HARIKRUTHIK/Precision-Scalable-4x4-NPU/docs/PSMAC_Complete_Guide.docx

PSMAC

Precision-Scalable Multiply-Accumulate Unit

Complete Line-by-Line RTL Code Guide

8 Verilog Modules | 3 Precision Modes | 4× INT2 Throughput | 20/20 Tests Passing

What is PSMAC?

PSMAC (Precision-Scalable Multiply-Accumulate) is a hardware accelerator written in synthesisable Verilog RTL. It computes the dot product of two vectors — the core arithmetic operation of every neural network layer — while allowing the operator to switch between 8-bit, 4-bit, and 2-bit integer arithmetic at runtime with zero stall cycles and zero hardware reconfiguration.

The same silicon area that normally handles one INT8 multiplication per cycle instead handles two INT4 or four INT2 multiplications per cycle by packing multiple operands into one datapath traversal. This is the central novelty of the design.

# Section 0 — Full System Architecture

Module Hierarchy (Bottom → Top)

How modules nest inside each other

ha, fa → primitive adder cells defined inside sbb.v

sbb → 3-bit × 3-bit signed multiplier cell (uses ha + fa internally)

BBU → 4-bit × 4-bit decomposition using 4× sbb

rfu → 8-bit × 8-bit decomposition using 4× BBU; emits 80-bit packed result

weight_mem → dual 256×8 RAM (activations + weights); async read

pipe_reg → 80-bit pipeline register; isolates RFU timing

accumulator → extracts correct fields from 80-bit bus; adds to 32-bit sum

fsm → 4-state Moore controller; drives address, enables, out_valid

psmac_top → top-level integrator; wires all above + adds pipeline delay corrections

Two-Cycle Pipeline Overview

When | Stage | What Happens
Cycle N | FSM drives addr | weight_mem reads x[addr] and w[addr] combinationally → rfu computes 80-bit result immediately
Cycle N | RFU combinational | Result rfu_out_wire is ready in the same cycle — no clock edge needed
Cycle N+1 | pipe_reg latches | On the rising clock edge, pipe_reg stores rfu_out_wire → data_out is now stable
Cycle N+1 | acc_en_d1 fires | psmac_top delays acc_en by 1 cycle so it aligns with pipe_reg output
Cycle N+1 | Accumulator adds | result ← result + tree_out (the extracted partial product for this mode)
End | FSM → DONE → out_valid | ov_d1 is asserted one cycle later, confirming result is fully stable

# Section 1 — sbb.v (Sub-word Building Block)

## 1.1 Purpose

The sbb is the lowest-level compute cell in the entire design. It is a custom 3-bit × 3-bit signed multiplier built from scratch using individual gate-level adder primitives (ha, fa). It produces a 5-bit signed product.

Its unique feature is the sx and sy sign-enable flags: when sx = 0 the MSB of x is masked off, making the operand behave as unsigned. This single AND gate eliminates the need for a separate unsigned multiplier path.

## 1.2 Port List

Port | Description
x[2:0] | 3-bit input operand X (a nibble half sliced from a larger value by BBU)
y[2:0] | 3-bit input operand Y (a nibble half sliced from a larger value by BBU)
sx | Sign-enable for X: when 1, x[2] is treated as a sign bit (2's complement); when 0, x is unsigned
sy | Sign-enable for Y: same logic as sx but for Y
p[4:0] | 5-bit signed product output — the result of x × y with appropriate sign handling

## 1.3 Line-by-Line Explanation

Line | Code | Explanation
1 | module sbb ( | Declares the module named sbb. All five ports follow.
2 | input [2:0] x, | 3-bit input bus named x. Bit-0 is LSB, bit-2 is MSB.
3 | input [2:0] y, | 3-bit input bus named y.
4 | input sx, | 1-bit sign-enable for x. Passed in by BBU depending on which nibble x represents.
5 | input sy, | 1-bit sign-enable for y. Same idea for y.
6 | output signed [4:0] p | 5-bit signed output p. The 'signed' keyword tells the simulator to interpret overflow correctly.
7 | ); | Closes the port list, begins the module body.
9 | wire x2 = x[2] & sx; | KEY LINE: x2 is the effective sign bit of x. If sx=1, x2 = x[2] (normal sign). If sx=0, x2 = 0 — x is treated as unsigned automatically. One AND gate, zero extra hardware.
10 | wire y2 = y[2] & sy; | Same sign-masking for y. y2 is y's effective sign bit.
12 | wire x0y0 = x[0] & y[0]; | Partial product: bit-0 of x AND bit-0 of y. This is the AND-based multiplication of the two LSBs.
13 | wire x0y1 = x[0] & y[1]; | Partial product: x[0] × y[1]. Used to form bit-1 and bit-2 of the final product.
14 | wire x0y2 = ~(x[0] & y2); | Partial product involving the sign bit y2. The NAND (~&) is part of the Baugh-Wooley signed multiply technique — sign bits are negated in the partial product array.
15 | wire x1y0 = x[1] & y[0]; | Partial product: x[1] × y[0].
16 | wire x1y1 = x[1] & y[1]; | Partial product: x[1] × y[1]. Falls in the middle of the reduction tree.
17 | wire x1y2 = ~(x[1] & y2); | NAND partial product for the sign-bit cross term x[1]×y2.
18 | wire x2y0 = ~(x2 & y[0]); | NAND partial product for sign-bit cross term x2×y[0].
19 | wire x2y1 = ~(x2 & y[1]); | NAND partial product for sign-bit cross term x2×y[1].
20 | wire x2y2 = x2 & y2; | AND partial product of both sign bits. The only sign×sign term that remains AND (not NAND) in Baugh-Wooley.
22 | assign p[0] = x0y0; | Bit-0 of product = LSB partial product directly. No carry can affect bit-0.
25 | ha HA1 (.a(x0y1),.b(x1y0),.s(p[1]),.c(c1)); | Half Adder to sum two partial products for bit-1. The sum bit goes to p[1], carry c1 goes to the next stage.
29 | fa FA1 (.a(x1y1),.b(x2y0),.cin(c1),.s(s_fa1),.cout(c2)); | Full Adder for bit-2 level: adds x1y1 + x2y0 + carry-in c1. Produces intermediate sum s_fa1 and carry c2.
33 | ha HA2 (.a(s_fa1),.b(x0y2),.s(p[2]),.c(c3)); | Second Half Adder: combines s_fa1 and x0y2 to give p[2]. Carry c3 propagates.
37 | fa FA2 (.a(1'b1),.b(x2y1),.cin(c2),.s(s_fa2),.cout(c4)); | The constant 1'b1 here is the Baugh-Wooley correction term — needed to fix the sign-bit NAND terms. Without this '1', the signed product would be wrong.
41 | fa FA3 (.a(s_fa2),.b(x1y2),.cin(c3),.s(p[3]),.cout(c5)); | Third Full Adder: computes bit-3 of the product from the previous stage sums and carries.
44 | assign p[4] = (x2^y2)&(x[1]|x[0])&(y[1]|y[0]); | Bit-4 (the MSB / sign bit of the result). This is a compact logic expression that evaluates whether the product is negative: true only when the signs differ AND both operands are non-zero. This is a design optimisation — avoids a full carry chain up to bit-4.

## 1.4 The ha and fa Sub-modules (defined at bottom of sbb.v)

Module | Function
ha (Half Adder) | Takes two 1-bit inputs a,b. Output s = a XOR b (sum bit), c = a AND b (carry bit). Used wherever two partial products are combined.
fa (Full Adder) | Takes three 1-bit inputs a,b,cin. Internally uses two ha instances. Output s = sum, cout = carry. Used at higher bit positions where a carry-in exists.

## 1.5 Role in psmac_top

sbb is never instantiated directly by psmac_top. It is instantiated 4 times inside BBU, which is itself instantiated 4 times inside rfu. So the full design contains 16 sbb instances in total — all operating in parallel, every clock cycle, combinationally.

# Section 2 — BBU.v (Basic Building Unit)

## 2.1 Purpose

The BBU implements Karatsuba decomposition at the 4-bit level. It takes two 4-bit nibbles and splits each into a 2-bit high part and 2-bit low part, computes four 3×3 sub-products using four sbb instances, then either concatenates them (INT2 mode) or recombines them using Karatsuba's formula (INT4/INT8 modes).

The output is 20 bits wide — four 5-bit raw products packed together in INT2 mode, or one 11-bit fused product sign-extended to 20 bits in INT4/INT8 modes.

## 2.2 Port List

Port | Description
x[3:0] | 4-bit input operand X — a nibble (half of the 8-bit operand) from the rfu
y[3:0] | 4-bit input operand Y — a nibble from the rfu
sx | Sign-enable flag for x, passed through to the relevant sbb instances
sy | Sign-enable flag for y, passed through to the relevant sbb instances
mode[1:0] | Precision mode: 2'b00=INT2, 2'b01=INT4, 2'b10=INT8
out[19:0] | 20-bit output. Layout depends on mode — either four packed raw products or one fused result

## 2.3 Line-by-Line Explanation

Line | Code | Explanation
1 | module BBU( | Declares the BBU module.
2 | input [3:0] x, y, | Two 4-bit nibble inputs.
3 | input sx, sy, | Sign-enable flags, one per operand.
4 | input [1:0] mode, | 2-bit mode selector (INT2/INT4/INT8).
5 | output [19:0] out | 20-bit output — holds either packed raw sub-products or a single fused Karatsuba product.
8 | wire [2:0] xH = {x[3], x[3:2]}; | HIGH nibble of x, extended to 3 bits for sbb. {x[3],x[3:2]} sign-extends bit-3 into bit-2's position, so the sbb sees the correct 2-bit value in a 3-bit container.
9 | wire [2:0] xL = {1'b0, x[1:0]}; | LOW nibble of x, zero-extended to 3 bits. No sign in the low part — it is always treated as unsigned by the sbb (sx=0 will be passed).
10 | wire [2:0] yH = {y[3], y[3:2]}; | High nibble of y, same sign-extension treatment.
11 | wire [2:0] yL = {1'b0, y[1:0]}; | Low nibble of y, zero-extended.
13 | wire signed [4:0] p00,p01,p10,p11; | Four 5-bit signed wires to hold the four sub-products from the four sbb instances.
15 | sbb SBB00(.x(xL),.y(yL),.sx(1'b0),.sy(1'b0),.p(p00)); | SBB00 computes xL × yL. Both sign-enables are 0 — low nibbles are always unsigned in Karatsuba decomposition.
16 | sbb SBB01(.x(xL),.y(yH),.sx(1'b0),.sy(sy),.p(p01)); | SBB01 computes xL × yH. xL is unsigned (sx=0), yH may be signed (sy is passed through).
17 | sbb SBB10(.x(xH),.y(yL),.sx(sx),.sy(1'b0),.p(p10)); | SBB10 computes xH × yL. xH may be signed (sx is passed through), yL is unsigned.
18 | sbb SBB11(.x(xH),.y(yH),.sx(sx),.sy(sy),.p(p11)); | SBB11 computes xH × yH. Both may be signed — this is the most-significant sub-product.
20 | wire signed [5:0] mid = p01 + p10; | Karatsuba cross-term: sum of the two middle sub-products. This is the (xL×yH + xH×yL) term needed to reconstruct the full product. 6 bits to absorb potential carry.
21 | wire signed [10:0] p11_shifted = {{2{p11[4]}},p11,4'b0000}; | p11 (xH×yH) represents the high×high term. It must be left-shifted by 4 bits (multiplied by 2^4=16) to align with its correct bit position. Sign-extended to 11 bits.
22 | wire signed [10:0] mid_shifted = {{3{mid[5]}},mid,2'b00}; | Cross-term mid must be left-shifted by 2 bits (×4) to align with its bit position. Sign-extended.
23 | wire signed [10:0] p00_ext = {{6{p00[4]}},p00}; | p00 (xL×yL) is the low×low term. No shift needed — it already occupies bits [3:0]. Just sign-extended to 11 bits.
25 | wire signed [10:0] fused = p11_shifted + mid_shifted + p00_ext; | KARATSUBA RECONSTRUCTION: adds the three shifted partial products to get the full 4-bit × 4-bit product in 11 bits. This is the mathematical formula: result = pH×pH<<4 + (pH×pL + pL×pH)<<2 + pL×pL.
28 | wire [4:0] p00u=p00[4:0]; ... | Aliases to the four raw sub-products cast as unsigned — used in INT2 output mode where we want the raw values, not the fused sum.
31 | assign out = (mode==2'b00) ? {p11u,p10u,p01u,p00u} | INT2 MODE: output is the four 5-bit raw sub-products packed together. Each represents an independent 2-bit × 2-bit product. Total = 20 bits.
32 | : {{9{fused[10]}}, fused}; | INT4/INT8 MODE: output is the 11-bit fused Karatsuba result, sign-extended to 20 bits. The 9 extra bits are copies of the sign bit (fused[10]).

## 2.4 Role in psmac_top

BBU is instantiated 4 times inside rfu (BBU0–BBU3). It is never called directly from psmac_top. The four instances correspond to the four quadrant sub-products of the 8-bit × 8-bit Karatsuba level:

Instance | Sub-product computed
BBU0 (xL×yL) | Lower 4 bits of x × lower 4 bits of y. Both sign-enables = 0.
BBU1 (xL×yH) | Lower 4 bits of x × upper 4 bits of y. sy passed through.
BBU2 (xH×yL) | Upper 4 bits of x × lower 4 bits of y. sx passed through.
BBU3 (xH×yH) | Upper 4 bits of x × upper 4 bits of y. Both sx,sy passed through.

# Section 3 — rfu.v (Reconfigurable Functional Unit)

## 3.1 Purpose

The rfu is the full 8-bit × 8-bit computation engine. It applies Karatsuba decomposition at the 8-bit level: it splits both 8-bit operands into high and low 4-bit nibbles, instantiates four BBUs to compute all four quadrant products, then assembles a 80-bit packed output bus whose format changes based on the precision mode.

The 80-bit output is the richest data structure in the design — it simultaneously contains all the information needed for INT2, INT4, and INT8 results, packed into specific bit fields that the accumulator later extracts.

## 3.2 Port List

Port | Description
x[7:0] | Full 8-bit activation operand
y[7:0] | Full 8-bit weight operand
sx | Sign-enable for x — whether the MSB of x should be treated as sign
sy | Sign-enable for y — whether the MSB of y should be treated as sign
mode[1:0] | Precision selector: 2'b10=INT8, 2'b01=INT4, 2'b00=INT2
out[79:0] | 80-bit packed result. Bit-field layout depends on mode

## 3.3 Line-by-Line Explanation

Line | Code | Explanation
1 | module rfu( | Declares the rfu module.
7 | wire [3:0] xH = x[7:4]; | High nibble of x: bits 7 down to 4. These are the most significant 4 bits.
8 | wire [3:0] xL = x[3:0]; | Low nibble of x: bits 3 down to 0. These are the least significant 4 bits.
9 | wire [3:0] yH = y[7:4]; | High nibble of y.
10 | wire [3:0] yL = y[3:0]; | Low nibble of y.
12 | wire [19:0] p0,p1,p2,p3; | Four 20-bit wires for the four BBU outputs. Each BBU produces 20 bits (either 4×5-bit raw or 1×11-bit fused sign-extended).
14 | BBU BBU0(.x(xL),.y(yL),.sx(1'b0),.sy(1'b0),.mode(mode),.out(p0)); | BBU0 computes the xL×yL quadrant. Low×low is always unsigned — both sign flags hardwired to 0.
15 | BBU BBU1(.x(xL),.y(yH),.sx(1'b0),.sy(sy),.mode(mode),.out(p1)); | BBU1 computes xL×yH. xL unsigned, yH sign depends on sy.
16 | BBU BBU2(.x(xH),.y(yL),.sx(sx),.sy(1'b0),.mode(mode),.out(p2)); | BBU2 computes xH×yL. xH sign depends on sx, yL unsigned.
17 | BBU BBU3(.x(xH),.y(yH),.sx(sx),.sy(sy),.mode(mode),.out(p3)); | BBU3 computes xH×yH. Both signs passed through — this is the highest-significance quadrant.
19 | wire signed [10:0] p0_11 = $signed(p0[10:0]); | Extract the lower 11 bits of BBU0's output and interpret as signed. In INT4/INT8 mode, bits[10:0] of each BBU hold the fused 11-bit Karatsuba product.
20 | wire signed [10:0] p1_11 = $signed(p1[10:0]); | Same for BBU1's fused product.
21 | wire signed [10:0] p2_11 = $signed(p2[10:0]); | Same for BBU2's fused product.
22 | wire signed [10:0] p3_11 = $signed(p3[10:0]); | Same for BBU3's fused product.
24 | wire signed [11:0] mid = p1_11 + p2_11; | Karatsuba cross-term at the 8-bit level: sum of the two middle BBU outputs (xL×yH + xH×yL). 12 bits to hold the sum without overflow.
25 | wire signed [18:0] p3_shifted = {p3_11,8'b0}; | BBU3 (xH×yH) result shifted left 8 bits — equivalent to multiplying by 2^8=256. Aligns the high×high quadrant to its correct position in the 16-bit product.
26 | wire signed [18:0] mid_shifted = {{3{mid[11]}},mid,4'b0}; | Cross-term shifted left 4 bits (×16). Sign-extended to 19 bits.
27 | wire signed [18:0] p0_ext = {{8{p0_11[10]}},p0_11}; | BBU0 (xL×yL) result, no shift needed — already at bit position 0. Sign-extended to 19 bits.
28 | wire signed [18:0] fused_ext = p3_shifted+mid_shifted+p0_ext; | INT8 KARATSUBA RECONSTRUCTION: adds the three shifted partial products to get the complete 8-bit × 8-bit product.
29 | wire signed [15:0] fused = fused_ext[15:0]; | Truncate to 16 bits — the maximum result width for 8-bit × 8-bit signed multiplication (range: −32768 to +32767).
31 | assign out = (mode==2'b00) | Begin the 3-way output MUX — the key mode-switching logic.
32 | ? {p3[19:0],p2[19:0],p1[19:0],p0[19:0]} | INT2 MODE: concatenate all four full 20-bit BBU outputs into 80 bits. Each BBU holds four 5-bit raw 2×2 products packed together, giving 16 independent 2-bit products per rfu call.
33 | : (mode==2'b01) | Check for INT4 mode.
34 | ? {36'b0,p3[10:0],p2[10:0],p1[10:0],p0[10:0]} | INT4 MODE: take only the lower 11 bits (fused product) from each BBU and pack them into 44 bits, padded with 36 zeros to fill the 80-bit bus.
35 | : {64'b0, fused}; | INT8 MODE: only the 16-bit fused result matters. Placed in bits[15:0], upper 64 bits are zero.

## 3.4 The 80-bit Output Bus — Bit Field Map

How the 80-bit bus is populated in each mode

INT8 (mode=2'b10): bits[79:16] = 0 | bits[15:0] = 16-bit fused INT8 product

INT4 (mode=2'b01): bits[79:44]=0 | [43:33]=BBU3.fused | [32:22]=BBU2.fused | [21:11]=BBU1.fused | [10:0]=BBU0.fused

INT2 (mode=2'b00): bits[79:60]=BBU3 raw 20b | [59:40]=BBU2 raw 20b | [39:20]=BBU1 raw 20b | [19:0]=BBU0 raw 20b

The accumulator uses this map to know exactly which bits to sign-extend and sum, depending on mode_out.

# Section 4 — weight_mem.v (Dual Memory Bank)

## 4.1 Purpose

The weight_mem stores both the activation vector (x_mem) and the weight vector (w_mem) in two independent 256-entry × 8-bit RAM banks. Writes are synchronous (one byte per clock edge). Reads are fully asynchronous (combinational) — the output x_out and w_out appear in the same cycle that addr is driven, with no clock delay.

This asynchronous read is a deliberate design choice: it allows the RFU to start computing in Cycle N (the same cycle the FSM drives the address), which is what makes the 2-cycle pipeline tight.

## 4.2 Port List

Port | Description
clk | Clock input — used only for synchronous writes
addr[7:0] | Read address driven by FSM. Same address used for both banks simultaneously
we_w | Write enable for weight bank — when high, w_mem[w_addr] ← w_data on clock edge
w_addr[7:0] | Write address for weight bank
w_data[7:0] | 8-bit data to write into weight bank
we_x | Write enable for activation bank
x_addr[7:0] | Write address for activation bank
x_data[7:0] | 8-bit data to write into activation bank
x_out[7:0] | Async read output: current activation byte at addr
w_out[7:0] | Async read output: current weight byte at addr

## 4.3 Line-by-Line Explanation

Line | Code | Explanation
1 | module weight_mem #(parameter DEPTH=256)( | Parameterized module — DEPTH can be overridden at instantiation. Default is 256 entries.
8 | reg [7:0] x_mem [0:DEPTH-1]; | Declares the activation RAM: an array of DEPTH (256) registers, each 8 bits wide.
9 | reg [7:0] w_mem [0:DEPTH-1]; | Declares the weight RAM: same structure. Two independent banks.
11 | assign x_out = x_mem[addr]; | ASYNCHRONOUS READ for activations: x_out is a continuous assignment — it updates immediately whenever addr changes, with no clock edge required. This is what makes Cycle N computation possible.
12 | assign w_out = w_mem[addr]; | ASYNCHRONOUS READ for weights: same — w_out updates immediately with addr.
14 | always @(posedge clk) begin | Synchronous write block — only triggers on the rising clock edge.
15 | if (we_w) w_mem[w_addr] <= w_data; | If write-enable for weights is high, write w_data into w_mem at address w_addr. Non-blocking assignment (<=) ensures correct sequential behaviour.
18 | always @(posedge clk) begin | Second synchronous write block — for the activation bank.
19 | if (we_x) x_mem[x_addr] <= x_data; | If write-enable for activations is high, write x_data into x_mem at x_addr.

## 4.4 Role in psmac_top

weight_mem is instantiated once as WEIGHT_MEM in psmac_top. The addr input comes from the FSM's addr counter. The we_w/we_x write ports are connected directly to the top-level input pins, so the user can preload both memories before asserting psmac_en. The x_out and w_out outputs feed directly into the rfu instance.

# Section 5 — pipe_reg.v (Pipeline Register)

## 5.1 Purpose

The pipe_reg is a clocked 80-bit D-flip-flop bank. Its only job is to hold the RFU's combinational output stable for one clock cycle before the accumulator reads it. This stage-break is what converts the design from a pure combinational path (which would have a very long critical path) into a 2-stage pipeline with manageable timing.

It also latches mode, sx, and sy alongside the data, so the accumulator always knows what mode was in effect when this particular result was computed — even if the user changes mode between cycles.

## 5.2 Port List

Port | Description
clk | Clock — all latching happens on the rising edge
rst | Synchronous reset — all outputs go to zero
en | Enable signal — output only updates when en=1 (connected to pipe_en from FSM)
sx, sy | Sign-enable flags — latched alongside the data
mode_in[1:0] | Precision mode — latched alongside the data
rfu_out[79:0] | 80-bit combinational result from the rfu — this is what gets latched
data_out[79:0] | Registered output — stable 80-bit value for the accumulator
mode_out[1:0] | Registered mode — tells accumulator how to interpret data_out
sx_out,sy_out | Registered sign flags — forwarded to accumulator

## 5.3 Line-by-Line Explanation

Line | Code | Explanation
1 | module pipe_reg( | Declares the pipeline register module.
2 | input clk,rst,en,sx,sy, | All control signals declared in one line. en controls whether the register captures a new value this cycle.
3 | input [1:0]mode_in, | The current precision mode — must be stored alongside data so accumulator knows how to interpret it.
4 | input [79:0]rfu_out, | The 80-bit combinational output of the RFU — this is the new data to potentially latch.
5 | output reg [79:0] data_out, | Registered (clocked) 80-bit output. 'reg' means it holds its value between clock edges.
6 | output reg [1:0]mode_out, | Registered mode output.
7 | output reg sx_out, sy_out | Registered sign flag outputs.
10 | always @(posedge clk) begin | All logic triggers on the rising clock edge only.
11 | if (rst) begin | Synchronous reset: if rst is high at the clock edge, clear all outputs.
12 | data_out<=0; | Reset data to zero. Non-blocking — all resets happen simultaneously.
13 | mode_out<=0; sx_out<=0; sy_out<=0; | Reset metadata signals to zero.
16 | else if (en) begin | Only update if en=1 (pipe_en from FSM). This prevents the register from capturing garbage during IDLE/CLEAR states.
17 | data_out<=rfu_out; | Latch the RFU's current 80-bit output. On the next cycle, data_out is stable.
18 | mode_out<=mode_in; | Latch the current mode — ensures the accumulator uses the mode that was active during this computation.
19 | sx_out<=sx; sy_out<=sy; | Latch sign flags for the same reason.

## 5.4 Role in psmac_top

pipe_reg is instantiated as PIPELINE in psmac_top. Its en input is pipe_en from the FSM (active during RUN and DONE states). Its data_out feeds the accumulator. Its mode_out tells the accumulator which bit fields to extract. The key insight: pipe_reg output is always one cycle behind the rfu output, which is why acc_en must also be delayed by one cycle (acc_en_d1 in psmac_top).

# Section 6 — accumulator.v (Precision-Aware Accumulator)

## 6.1 Purpose

The accumulator is where the final dot-product sum is built up. It receives the 80-bit packed bus from pipe_reg and uses mode_out to determine which bit fields hold valid numerical results. It sign-extends those fields to 32 bits and adds them to a running result register.

This is the module that makes the throughput multiplier real: in INT4 mode, it adds two products per cycle; in INT2 mode, it adds four products per cycle — all from a single 80-bit bus read.

## 6.2 Port List

Port | Description
clk | Clock input
rst | Synchronous reset — clears result to zero
data_out[79:0] | 80-bit packed input from pipe_reg
mode_out[1:0] | Precision mode from pipe_reg — controls which bit fields to extract
acc_en | Accumulate enable — when high, result ← result + tree_out (this is acc_en_d1 from psmac_top, not the raw FSM signal)
clear | Clear enable — resets result to zero (used at start of each computation)
result[31:0] | 32-bit signed accumulated output — the final dot-product answer

## 6.3 Line-by-Line Explanation

Line | Code | Explanation
1 | module accumulator( | Declares the accumulator module.
7 | wire signed [31:0] int8_sum = {{16{data_out[15]}},data_out[15:0]}; | INT8 extraction: take bits[15:0] (the 16-bit fused Karatsuba result from rfu) and sign-extend it to 32 bits by replicating bit-15 sixteen times. {{16{data_out[15]}}} is Verilog sign-extension syntax.
10 | wire signed [31:0] int4_p0 = {{21{data_out[10]}},data_out[10:0]}; | INT4 first product: extract bits[10:0] — the BBU0 fused result (xL×yL quadrant). Sign-extended to 32 bits. This represents the dot product of the lower nibbles.
11 | wire signed [31:0] int4_p3 = {{21{data_out[43]}},data_out[43:33]}; | INT4 second product: extract bits[43:33] — the BBU3 fused result (xH×yH quadrant). Sign-extended. This represents the dot product of the upper nibbles. Two independent 4-bit products in one cycle.
12 | wire signed [31:0] int4_sum = int4_p0 + int4_p3; | Add the two INT4 products together. This gives the total contribution of both 4-bit pairs for this cycle to the running dot product.
15 | wire signed [31:0] int2_p0 = {{27{data_out[4]}},data_out[4:0]}; | INT2 product 0: bits[4:0] = SBB00 inside BBU0 = x[1:0]×y[1:0] (the very lowest 2-bit pair). Sign-extended to 32 bits.
16 | wire signed [31:0] int2_p1 = {{27{data_out[19]}},data_out[19:15]}; | INT2 product 1: bits[19:15] = SBB11 inside BBU0 = x[3:2]×y[3:2] (second 2-bit pair). These are the high sub-products of BBU0.
17 | wire signed [31:0] int2_p2 = {{27{data_out[64]}},data_out[64:60]}; | INT2 product 2: bits[64:60] = SBB00 inside BBU3 = x[5:4]×y[5:4] (third 2-bit pair). From BBU3's raw output region.
18 | wire signed [31:0] int2_p3 = {{27{data_out[79]}},data_out[79:75]}; | INT2 product 3: bits[79:75] = SBB11 inside BBU3 = x[7:6]×y[7:6] (the highest 2-bit pair).
19 | wire signed [31:0] int2_sum = int2_p0+int2_p1+int2_p2+int2_p3; | Add all four INT2 products: four independent 2-bit × 2-bit results accumulated in a single cycle. This is 4× the throughput of INT8.
21 | wire signed [31:0] tree_out = (mode_out==2'b10) ? int8_sum : | Mode-select MUX: if INT8, the single 16-bit product is used.
22 | (mode_out==2'b01) ? int4_sum : int2_sum; | If INT4, the sum of two 4-bit products. Otherwise INT2, sum of four 2-bit products. tree_out is the contribution of this one pipeline stage to the final dot product.
24 | always @(posedge clk) begin | Clocked accumulation logic.
25 | if (rst) result <= 32'b0; | Synchronous reset: result goes to zero immediately on rst.
26 | else if (clear) result <= 32'b0; | Clear command from FSM (CLEAR state): reset before a new computation starts.
27 | else if (acc_en) result <= result + tree_out; | ACCUMULATION: on each clock where acc_en=1, add tree_out to the running sum. This builds up the dot product over vec_len/run_target cycles.

## 6.4 Role in psmac_top

Instantiated as ACCUMULATOR. Receives data_out and mode_out from pipe_reg. The critical point: its acc_en input is connected to acc_en_d1 (not the raw FSM acc_en) — this 1-cycle delay is what synchronises it with the pipe_reg latency. Without this delay, the accumulator would read the previous cycle's pipe_reg output instead of the current one.

# Section 7 — fsm.v (Finite State Machine Controller)

## 7.1 Purpose

The fsm is the 4-state Moore FSM that orchestrates the entire dot-product computation. It controls the memory address counter, the pipeline and accumulator enables, and the output-valid signal. It also implements the throughput-scaling logic: by computing run_target as a right-shifted version of vec_len, it automatically runs fewer cycles in lower-precision modes — because each RFU cycle packs more work.

## 7.2 States

State | Behaviour
IDLE (2'b00) | Waits for psmac_en=1. No outputs are asserted. The FSM sits here between computations.
CLEAR (2'b01) | Asserts clear=1 for one cycle to zero the accumulator. Resets the address counter. Immediately transitions to RUN.
RUN (2'b10) | The main compute state. Each cycle: increments addr counter, asserts acc_en and pipe_en. Runs for run_target cycles.
DONE (2'b11) | Computation complete. Asserts out_valid (registered). Holds pipe_en high for one extra cycle to drain the pipeline. Returns to IDLE.

## 7.3 Line-by-Line Explanation

Line | Code | Explanation
1 | module fsm( | Declares the FSM module.
9 | parameter IDLE=2'b00; CLEAR=2'b01; | State encoding constants. 2-bit binary encoding for 4 states.
10 | parameter RUN=2'b10; DONE=2'b11; | RUN and DONE state encodings.
13 | reg [1:0] state, next_state; | Current state register and next-state combinational wire (declared as reg for always block use).
14 | reg [7:0] counter; | 8-bit address counter — incremented every cycle in RUN state, drives the memory address.
15 | reg [7:0] run_target; | Computed number of cycles needed for this precision mode and vector length.
17 | always @(*) begin | Combinational block — run_target is computed continuously based on mode.
18 | case(mode) | Switch on current mode.
19 | 2'b10: run_target = vec_len; | INT8 mode: one product per cycle, so run exactly vec_len cycles.
20 | 2'b01: run_target = vec_len >> 1; | INT4 mode: two products per cycle (one rfu call handles 2 pairs), so need only vec_len/2 cycles.
21 | 2'b00: run_target = vec_len >> 2; | INT2 mode: four products per cycle, so need only vec_len/4 cycles. This is where 4× throughput comes from.
26 | always @(posedge clk) begin | Sequential block: state register and counter update on clock edge.
27 | if (rst) begin state<=IDLE; counter<=0; | On reset: go to IDLE, clear counter.
31 | state <= next_state; | Update current state to whatever the combinational next-state logic computed.
32 | case(state) | Counter update logic: counter only increments in RUN state.
33 | IDLE: counter <= 8'b0; | Reset counter to 0 in IDLE.
34 | CLEAR: counter <= 8'b0; | Keep counter at 0 in CLEAR (about to start RUN).
35 | RUN: counter <= counter + 1; | Increment counter every cycle in RUN. This counter drives addr, so memory steps through entries 0,1,2,...
40 | always @(*) begin | Combinational next-state logic.
42 | IDLE: next_state = psmac_en?CLEAR:IDLE; | If psmac_en asserts, go to CLEAR; otherwise stay in IDLE.
43 | CLEAR: next_state = RUN; | Always go directly to RUN after CLEAR — clearing takes exactly 1 cycle.
44 | RUN: next_state = (counter==run_target-1)?DONE:RUN; | Stay in RUN until counter reaches run_target-1, then go to DONE. The -1 accounts for the counter updating on the same edge as the state transition.
45 | DONE: next_state = IDLE; | Always return to IDLE after DONE. One-cycle DONE state.
49 | always @(*) begin | Combinational output logic (Moore: outputs depend only on current state, not inputs).
50 | clear=0; acc_en=0; pipe_en=0; addr=0; | Default: all outputs deasserted. Safe default prevents latches.
53 | CLEAR: begin clear=1'b1; end | In CLEAR state: assert clear to zero the accumulator.
54 | RUN: begin acc_en=1; pipe_en=1; addr=counter; end | In RUN state: assert acc_en (will become acc_en_d1 after delay in psmac_top), pipe_en (allows pipe_reg to latch), and drive addr from counter.
55 | DONE: begin pipe_en=1; end | In DONE state: keep pipe_en high for one extra cycle to flush the final value through pipe_reg into the accumulator.
58 | always @(posedge clk) begin | Registered out_valid — must be a flip-flop to avoid glitches.
60 | else if (state==DONE) out_valid<=1'b1; | Assert out_valid when DONE state is reached.
61 | else if (state==IDLE && psmac_en) out_valid<=1'b0; | De-assert out_valid at the start of a new computation so it doesn't stay high from the previous run.

# Section 8 — psmac_top.v (Top-Level Integration)

## 8.1 Purpose

The psmac_top is the top-level system integrator. It does not perform any arithmetic itself. Its job is to:

- Instantiate all six sub-modules (fsm, weight_mem, rfu, pipe_reg, accumulator)
- Wire all their ports together in the correct order
- Apply two timing corrections that are the top module's responsibility: acc_en_d1 and ov_d1
- Expose debug probes so internal signals can be monitored during simulation

## 8.2 Complete Port List

Port | Description
clk | System clock — shared by all sub-modules
rst | Synchronous active-high reset — propagated to all sub-modules
psmac_en | Start trigger: rising edge (while in IDLE) begins a new dot-product computation
mode[1:0] | Precision mode: 2'b10=INT8, 2'b01=INT4, 2'b00=INT2. Can change between computations.
sx | Sign-enable for activation vector x: 1=signed, 0=unsigned
sy | Sign-enable for weight vector y: 1=signed, 0=unsigned
vec_len[7:0] | Number of elements in the vectors to dot-product. FSM computes run_target from this.
we_w | Write-enable for weight memory — load weights before asserting psmac_en
w_addr[7:0] | Address to write a weight byte into
w_data[7:0] | Weight byte value to write
we_x | Write-enable for activation memory
x_addr[7:0] | Address to write an activation byte into
x_data[7:0] | Activation byte value to write
result[31:0] | Final 32-bit signed dot-product result — valid when out_valid=1
out_valid | Pulses high for 1 cycle when result is ready (ov_d1 delayed version)
dbg_x_out | Debug probe: current activation byte being read from memory
dbg_w_out | Debug probe: current weight byte being read from memory
dbg_rfu_out | Debug probe: raw 80-bit rfu combinational output
dbg_pipe_out | Debug probe: 80-bit registered pipe_reg output
dbg_acc_en_d2 | Debug probe: the delayed acc_en_d1 signal going to accumulator
dbg_pipe_en | Debug probe: pipe_en from FSM
dbg_acc_en_fsm | Debug probe: raw acc_en from FSM (before delay)

## 8.3 The Two Critical Timing Corrections

Why these corrections are needed and exactly what they do

Correction 1: acc_en_d1

The FSM asserts acc_en in the RUN state. At that moment, the rfu has just computed a result — but the accumulator must read from pipe_reg, which is one cycle behind. If we gave acc_en directly to the accumulator, it would add the previous cycle's pipe_reg value (wrong). By delaying acc_en by one flip-flop (acc_en_d1), the enable arrives exactly when pipe_reg holds the correct latched value.

Correction 2: ov_d1 (out_valid delay)

The FSM asserts out_valid_fsm in the DONE state. But the last accumulation (acc_en_d1 firing) happens in the cycle after DONE. So out_valid needs one more cycle of delay to assert only after result is truly stable. ov_d1 provides this.

## 8.4 Line-by-Line Explanation

Line | Code | Explanation
1 | module psmac_top( | Declares the top-level module.
28 | wire clear,acc_en,pipe_en,out_valid_fsm; | Internal wires for FSM outputs. These carry signals between the FSM instance and the sub-module instances.
29 | wire [7:0] addr; | 8-bit address wire from FSM to weight_mem.
30 | wire [7:0] x_out,w_out; | 8-bit data wires from weight_mem to rfu.
31 | wire [79:0] rfu_out_wire; | 80-bit wire from rfu output to pipe_reg input.
32 | wire [79:0] data_out; | 80-bit wire from pipe_reg output to accumulator input.
33 | wire [1:0] mode_out; | 2-bit wire carrying latched mode from pipe_reg to accumulator.
34 | wire sx_out,sy_out; | 1-bit wires carrying latched sign flags from pipe_reg (not used by accumulator in current version, but available).
40 | reg acc_en_d1; | The 1-cycle-delayed version of acc_en. This is the signal actually passed to the accumulator.
41 | always @(posedge clk) begin | Sequential logic for acc_en_d1.
42 | if (rst) acc_en_d1<=1'b0; | On reset, clear the delayed enable.
43 | else acc_en_d1<=acc_en; | On every clock edge, capture the current acc_en. Output is therefore always exactly 1 cycle behind acc_en.
46 | reg ov_d1; | The 1-cycle-delayed out_valid. This is the signal exposed at the top-level out_valid port.
47 | always @(posedge clk) begin | Sequential logic for ov_d1.
49 | ov_d1<=out_valid_fsm; | Capture the FSM's raw out_valid. One cycle later, ov_d1 = 1 when result is stable.
51 | assign out_valid=ov_d1; | The top-level out_valid output is the delayed version.
53 | fsm FSM(...); | Instantiate the FSM. Connects: psmac_en, mode, vec_len → inputs; clear, acc_en, pipe_en, out_valid_fsm, addr → outputs.
63 | weight_mem #(.DEPTH(256)) WEIGHT_MEM(...); | Instantiate weight_mem with DEPTH=256. Connects: addr from FSM; we_w/w_addr/w_data and we_x/x_addr/x_data from top ports; x_out/w_out → rfu.
71 | rfu RFU(...); | Instantiate rfu. x=x_out, y=w_out, sx/sy/mode from top ports → out goes to rfu_out_wire.
78 | pipe_reg PIPELINE(...); | Instantiate pipe_reg. en=pipe_en from FSM, rfu_out=rfu_out_wire → data_out/mode_out for accumulator.
87 | accumulator ACCUMULATOR(...); | Instantiate accumulator. data_out and mode_out from pipe_reg, acc_en=acc_en_d1 (delayed), clear from FSM → result output.
95 | assign dbg_x_out = x_out; | Debug wires: expose internal signals to top-level ports for simulation testbench inspection.
96 | assign dbg_rfu_out = rfu_out_wire; | Exposes the raw 80-bit rfu output before the pipeline register — useful to compare against dbg_pipe_out.
97 | assign dbg_acc_en_d2 = acc_en_d1; | Exposes the delayed enable — so the testbench can verify the timing correction is working.

# Section 9 — Novelty of PSMAC

PSMAC's novelty consists of four interlocking contributions. Each is described below, with the specific line of code that implements it.

## Novelty 1 — Two-Level Karatsuba Hierarchy as a Precision Dial

What it is

Standard hardware multipliers are built for a single fixed width (e.g., a dedicated 8-bit multiplier). PSMAC instead implements a two-level Karatsuba decomposition: level 1 inside rfu splits 8-bit operands into 4-bit nibbles; level 2 inside BBU splits 4-bit nibbles into 2-bit sub-words. This means the hardware naturally generates products at three granularities simultaneously — 2-bit×2-bit, 4-bit×4-bit, and 8-bit×8-bit — from the same gate-level adder tree.

The mode selector is a zero-cost output MUX: it simply chooses which fields of the 80-bit bus to send to the accumulator. No extra computation is added or removed. The hardware always does the same work; the mode only changes how the results are interpreted.

Where in the code:

Location | What it does
BBU.v line 31-32 | OUT MUX: mode==2'b00 → raw sub-products (INT2), else → fused Karatsuba result (INT4/INT8)
rfu.v line 31-35 | 3-way output MUX: INT8 → 16-bit fused, INT4 → four 11-bit fused, INT2 → four 20-bit raw
accumulator.v 21-22 | tree_out MUX: extracts correct fields from 80-bit bus based on mode_out

## Novelty 2 — Sign Reconfigurability via sx/sy Flags with Zero Gate Overhead

What it is

Conventional precision-scalable designs handle signed vs unsigned modes either by duplicating hardware (one signed path + one unsigned path, then mux the output) or by pre-processing operands in software. Both approaches add area or latency.

PSMAC introduces a bit-level sign masking technique: inside sbb, the line wire x2 = x[2] & sx; implements the complete signed/unsigned switch with a single AND gate. When sx=0, x2 is always 0 — the MSB is masked off and the operand behaves as unsigned. When sx=1, x2=x[2] — normal signed 2's complement multiplication. This principle propagates naturally through BBU and rfu via selective pass-through of the sx/sy signals to only the appropriate sbb instances.

Where in the code:

Location | What it does
sbb.v line 9 | wire x2 = x[2] & sx; — the single AND gate that implements the entire signed/unsigned decision
BBU.v line 15-18 | sx/sy propagation: SBB00 gets (0,0), SBB01 gets (0,sy), SBB10 gets (sx,0), SBB11 gets (sx,sy) — matches mathematical sign rules
rfu.v line 14-17 | sx/sy propagation continues at 8-bit level with same quadrant-aware rules
pipe_reg.v | sx,sy latched alongside data — mode metadata preserved across pipeline stage

## Novelty 3 — Runtime Mode Switching with Zero Stall Cycles

What it is

Most flexible-precision accelerators require a pipeline flush, a mode register write, or a clock-gating reconfiguration before the precision can change. All of these cost cycles. PSMAC requires none of them.

The mode[1:0] wire feeds directly into: (a) the BBU output MUX, (b) the rfu output MUX, (c) the accumulator field-extraction logic, and (d) the FSM run_target computation. All of these are purely combinational. A new psmac_en pulse with a different mode simply starts a new computation at the new precision — effective on the very next CLEAR→RUN transition, with no overhead.

Where in the code:

Location | What it does
fsm.v line 17-22 | run_target recalculated every cycle combinationally from mode — immediate response to mode change
rfu.v line 31-35 | Output MUX is a combinational assign — no register holds old mode state
psmac_top.v | mode is passed directly (not registered) to rfu and through pipe_reg to accumulator

## Novelty 4 — FSM-Driven Throughput Scaling via run_target

What it is

Simply packing multiple operands into one datapath traversal is not enough — the control logic must also know how many cycles to run. The FSM's run_target variable is computed as vec_len >> {0,1,2} depending on mode. This means the hardware literally runs fewer clock cycles in lower-precision modes because each cycle contributes proportionally more to the dot product.

A 32-element vector dot product: INT8 requires 32 cycles, INT4 requires 16 cycles, INT2 requires just 8 cycles — using identical hardware. This is genuine throughput improvement, not just a relabelling of results.

Throughput table:

Mode | FSM run_target formula | Effective throughput
INT8 (2'b10) | run_target = vec_len | 1 product per cycle — baseline
INT4 (2'b01) | run_target = vec_len >> 1 | 2 products per cycle — 2× faster
INT2 (2'b00) | run_target = vec_len >> 2 | 4 products per cycle — 4× faster

Where in the code:

Location | What it does
fsm.v line 17-22 | run_target case statement — the 3-line implementation of the entire throughput scaling mechanism
fsm.v line 44 | (counter==run_target-1)?DONE:RUN — loop termination condition uses run_target
accumulator.v 19 | int2_sum = int2_p0+int2_p1+int2_p2+int2_p3 — 4 products added in one cycle

# Section 10 — PSMAC vs Alternative Designs

Feature | Fixed MAC | Clock-gated Flex | Systolic Array | PSMAC (This Work)
Supported precisions | 1 (fixed) | 2–3 | 1–2 | 3 (INT2/4/8)
Throughput gain at INT2 | None | None | Limited | 4× per cycle
Mode switch cost | N/A | Flush + config | Context switch | 0 cycles
Sign config method | Fixed | Separate path | Fixed | sx/sy flags (1 gate)
Sub-word packing | No | No | Partial | Yes, full 3-level
Karatsuba decomposition | No | No | No | Yes, 2-level
Extra area per mode | Full new die | Moderate | Large | Zero
Control complexity | Minimal | Moderate | High | 4-state FSM

# Section 11 — Complete Signal Flow: One Dot-Product Computation

## Step 1: Load Data (before psmac_en)

User drives we_x=1, x_addr=0..N-1, x_data=activation_bytes — fills x_mem. Then drives we_w=1, w_addr=0..N-1, w_data=weight_bytes — fills w_mem. Sets mode, sx, sy, vec_len.

## Step 2: Start (psmac_en = 1)

FSM: IDLE → CLEAR. One cycle: clear=1 zeroes the accumulator. FSM: CLEAR → RUN.

## Step 3: RUN state (run_target cycles)

Each cycle in RUN: FSM drives addr=counter → weight_mem outputs x_out, w_out combinationally → RFU computes 80-bit result → pipe_reg latches on clock edge (en=pipe_en) → one cycle later, acc_en_d1 fires → accumulator adds extracted partial products to result.

## Step 4: DONE state

FSM: RUN → DONE. pipe_en stays high for one drain cycle. out_valid_fsm=1. After ov_d1 delay, out_valid=1 at the top-level port. result holds the final 32-bit dot product.

## Step 5: Return to IDLE

FSM: DONE → IDLE. Ready for next computation. mode can be changed freely.

# Summary

2-Level Karatsuba Hierarchy | 1 Gate Sign Reconfiguration | 0 Stalls Mode Switch Cost | 4× INT2 Throughput Gain

Key Takeaway

Every module in PSMAC exists to serve one idea: the same adder tree that does one 8-bit multiply can simultaneously do four 2-bit multiplies — but only if the decomposition, sign-masking, output packing, accumulation, and control are all designed together as a unified system. That unified co-design is the essence of what makes PSMAC novel.

PSMAC · Precision-Scalable MAC · Verilog IEEE 1364-2001 · 8 Modules · 20/20 Tests Passing
