HARIKRUTHIK/Precision-Scalable-4x4-NPU/docs/Project_Specification.pdf

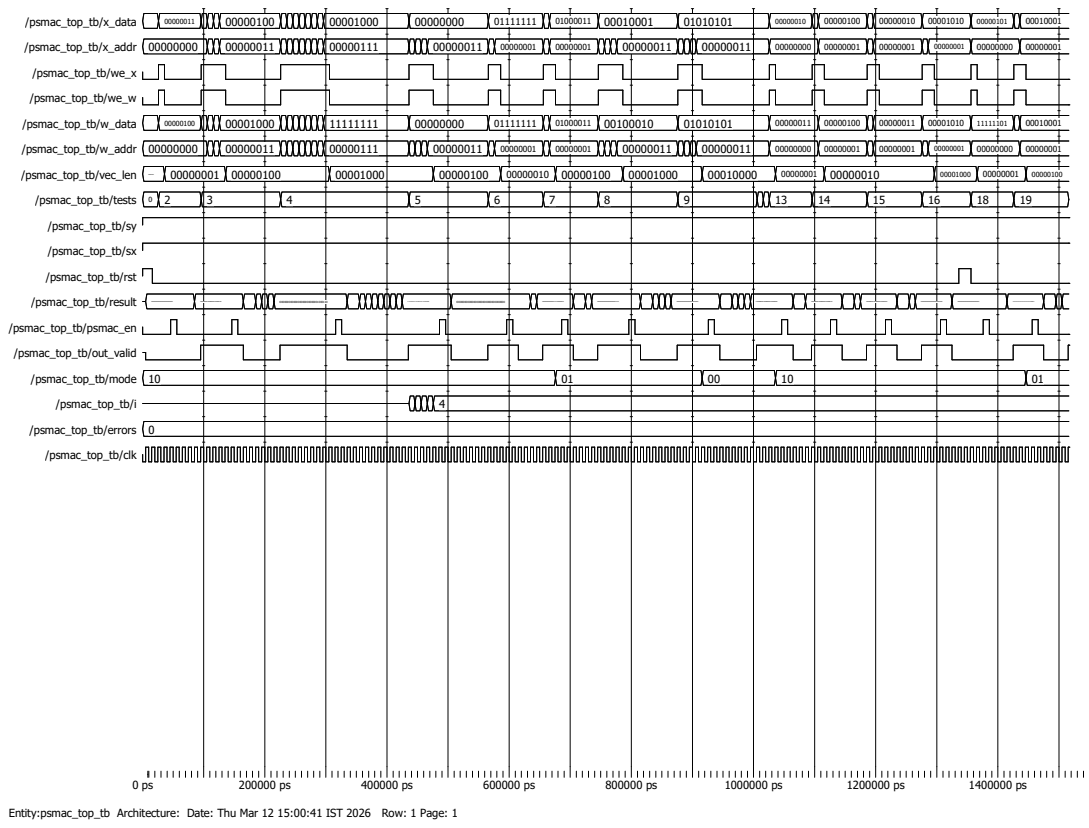
[picture p37: page 1]
/psmac_top_tb/x_data; /psmac_top_tb/x_addr 00000000; /psmac_top_tb/we_x; /psmac_top_tb/we_w; /psmac_top_tb/w_data; /psmac_top_tb/w_addr 00000000; /psmac_top_tb/vec_len 00000100; /psmac_top_tb/tests 0; /psmac_top_tb/sy; /psmac_top_tb/sx; /psmac_top_tb/rst; /psmac_top_tb/result 00000000000000000000000000000000; /psmac_top_tb/psmac_en; /psmac_top_tb/out_valid; /psmac_top_tb/mode 10; /psmac_top_tb/i; /psmac_top_tb/errors 0; /psmac_top_tb/clk

Entity:psmac_top_tb Architecture: Date: Thu Mar 12 15:00:41 IST 2026 Row: 1 Page: 1
